Cyberzunior/TMinus6---Nasa-Spaceapps/docs/parts_list.md

# Parts (short version; the full list with costs is in docs/)
**Have (kit + owned):** ELEGOO UNO R3, 2x Arduino UNO Q, LCD1602, 10k pot, buttons, DHT11, LEDs, resistors,
active + passive buzzer, PN2222, SG90, 28BYJ-48 + ULN2003, HC-SR04, 830 breadboard, MB102 + 9 V battery, jumper wires, USB cable.

**To buy / bring:** 4 TT motors + 4 wheels (65 mm), 2x DRV8833 module (one per side), 4 AA holder + 4 rechargeable AA,
capacitors (100 uF x3, 0.1 uF x6), mini breadboard, 40 female-to-male wires, ESP32-CAM or a phone,
2 power banks (one with USB-C + USB-A), 2 USB-C data cables, I2C 16x2 display, Bluetooth gamepad,
cardboard, tape, zip ties, hot glue, velcro, tub + foam ball (Earth).
