Cyberzunior/TMinus6---Nasa-Spaceapps/(commit log)

2026-11-14 Firmware v2: DRV8833 robot, weather zones, tower tuning, UNO Q bridges
    Robot: two DRV8833 drivers (D3/D5 left, D6/D9 right), stepper on D2/D4/D7/D8,
    non-blocking HC-SR04 state machine instead of pulseIn, link-lost and game-over
    latch behaviour, optional robot DHT11. Weather station: Z zone input, immediate W
    on state change, new LCD warning texts, optional I2C lives display. Tower:
    1.5 s fire gap, T,rest,push,ms tuning, pan servo. Linux-side bridge programs
    for both UNO Qs (UDP <-> Arduino Bridge, HELLO broadcast, latest-D-wins) with a
    --selftest that runs on a PC. Pin map and parts list updated.
    Not compiled or run on hardware yet.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
2026-11-14 Laptop game: simulator, discovery, auto-pilot, HUD, screens, tools
    Replaces the starter scripts with the full game: pygame-ce renderer with
    procedural Earth, ship, particles, bloom and vignette; HUD with hearts, weather
    panel, radar, camera; menu, settings, calibrate, hardware check, game-over
    animation and results. One mixer thread feeds both the craft and the robot
    (UDP D lines at 50 Hz); UDP and serial discovery with RTT and loss; 300 ms
    failsafe, game-over latch, emergency stop; hot/cold zones and spike warning;
    asteroid sequence synced to the tower K reply; the single auto-pilot; software
    versions of every device (--sim); command-line tools (hardware check, latency
    test, robot calibrati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
    [app.py, autopilot.py, calibration.py, camera.py, clock.py, config.py]
2026-11-14 Tests and README for the game
    60 headless tests (model, protocol, config, game rules, devices over loopback
    sockets, firmware static checks and bridge self-tests, full app flow in --sim)
    with a runner that needs no pytest. README: quick start, day-one connection
    checklist, controls, protocol notes, troubleshooting, honest status table.
